MiguelAlvarezBerjon/Electronic-Sound-Tuner/README.md

This project was carried out between September and December 2023 using Multisim, in collaboration with Jaime Santiago, under the guidance of Pablo Zumel from the Electronics Department at Universidad Carlos III de Madrid.
