MiguelAlvarezBerjon/Electronic-Sound-Tuner/Report.pdf

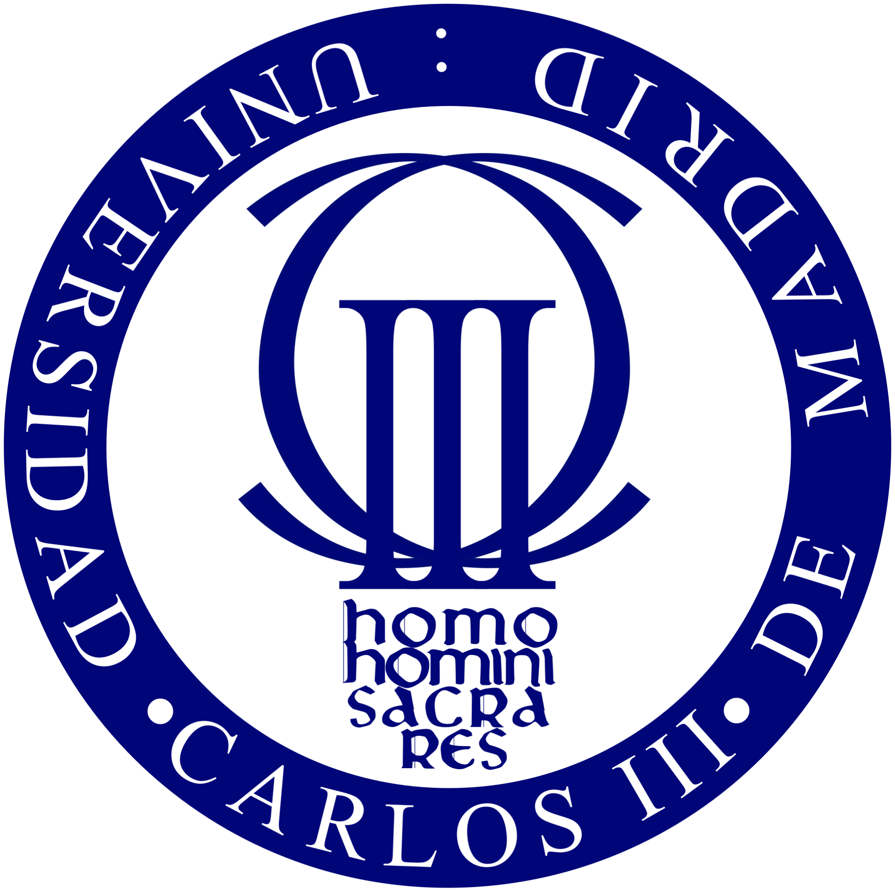
[picture p1: figure]

# INSTRUMENTACIÓN ELECTRÓNICA I

# PROYECTO DE DISEÑO

# Profesor: Pablo Zumel

Miguel Álvarez Berjón
Jaime de Santiago González

PROYECTO DE DISEÑO

ÍNDICE

1. Estado de la técnica
2. Descripción general a nivel de bloques de la solución adoptada
3. Descripción detallada del diseño propuesto que posibilite su reproducción.
4. Caracterización del funcionamiento
5. Presupuesto
6. Valoración crítica
7. Referencias bibliográficas utilizadas

### 1. ESTADO DE LA TÉCNICA

Los afinadores acústicos son ampliamente utilizados mayoritariamente en el campo de la música para saber con exactitud la nota que se está tocando y así poder afinar un instrumento. Desde un punto de vista más técnico, la mayoría de los afinadores indican mediante una señal visual la diferencia del sonido interpretado con el valor de la frecuencia exacta de la nota deseada.
Funcionaría de la siguiente manera: el micrófono captaría un sonido de determinada frecuencia que mediante una serie de circuitos integrados se transformaría en un voltaje determinado.
Este voltaje se compararía con el voltaje de referencia (que corresponde con la nota deseada y posteriormente se mostraría de manera visual o auditivamente para corregir la diferencia de valores.

Puesto que el montaje de dicho circuito se encuentra fuera de nuestras capacidades, el esquemático del proyecto se simplificará de manera significativa.
El micrófono se omitirá de manera que introduciremos la señal de frecuencia sinusoidal al circuito directamente utilizando un generador de funciones.
Dicha señal tendrá un voltaje determinado dado por una curva de calibración que mediante una serie de LEDS indicará qué nota está se recibiendo, según la correspondiente franja de voltaje en donde se encuentre.

Se han seguido las especificaciones dadas, utilizando únicamente los componentes recomendados y sin emplear microcontroladores ni sensores con salida digital.
Esta es una de las posibles soluciones al problema planteado, pero hay un gran número de ellas implementando distintos circuitos integrados cableado

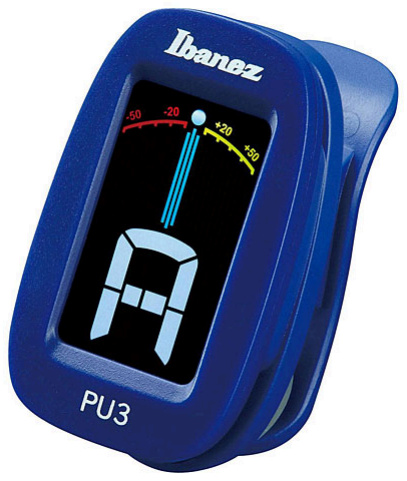
[picture p2: figure]

### 2. Descripción general a nivel de bloques de la solución adoptada

BLOQUE 1: FILTRO PASO BANDA
El TL082 se encuentra en el bloque de acondicionamiento de la señal al principio de circuito y funciona como un filtro paso banda que deja pasar unos niveles de frecuencia con una ganancia determinada por los componentes utilizados en el montaje y así garantizar el correcto funcionamiento del circuito, además de atenuar frecuencias no deseadas;
Consta de dos resistencias y 2 condensadores y recibe la señal del generador de funciones en su pata inversora, mientras que la pata no inversora está conectada a tierra.

BLOQUE 2: COMPARADOR
El LM311 se encuentra a la salida del TL082 para transformar la forma de onda de la frecuencia de senoidal a cuadrada y poder utilizar las puertas lógicas seguidamente; puesto que funciona como comparador y está conectado a conectado a un voltaje de ±5V se garantiza que la amplitud de la nueva onda tendrá 5V de valor máximo y 0 V de valor mínimo.
cuando V+>V-, el valor de la salida V0=+5V, mientras que cuando V-<V+, el valor de V0=0V

BLOQUE 3: CONFORMADOR DE PULSOS
El conformador de pulsos se encarga de general una señal de disparo del 555 continua mediante la implementación de puertas lógicas, además de haber un filtro paso bajo que mediante las funciones lógicas (en este caso únicamente se utilizan puertas NAND) nos da la forma de onda adecuada para el 555.

BLOQUE 4: 555 MONOESTABLE
Produce un pulso de anchura Tw constante que no varía. Recibe una valor de Vtrigger en la pata 2 de pulsos constantes del conformador. En la pata 5 de control de voltaje hemos puesto un condensador de 10nF para eliminar ruido. Puesto que el 555 funciona en modo monoestable, la pata 6 y 7, voltaje umbral y de descarga respectivamente, están conectados entre sí. Se encuentran en paralelo a la resistencia y el condensador del bloque.

BLOQUE 5: FILTRO PASO BAJO
Obtiene una señal continua de los pulsos del 555 adecuada para el circuito de ajuste, está conformado por varias resistencias en serie con un condensador conectado a tierra. Garantiza la atenuación de los valores superiores a la frecuencia de cortes establecida por los valores de los componentes de diseño.

BLOQUE 6: CIRCUITO DE AJUSTE
Sirve como proceso de transformación de la señal a la entrada de los TL082 a una señal pequeña y negativa.

BLOQUE 7: VISUALIZACIÓN
Sirve para, una vez recibe una señal de entrada Vin (entre 0-1,25V), según la frecuencia recibida el LM3914, envía corriente a uno de los leds colocados para, de esta manera, visualizar a simple vista la frecuencia recibida sin ser necesaria ninguna medición con aparatos externos.

### 3. Descripción detallada del diseño propuesto

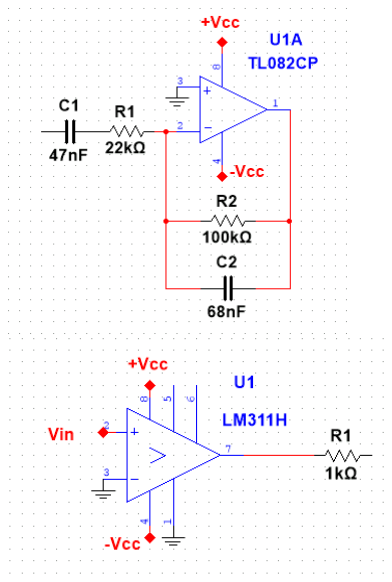
[picture p3: figure]

BLOQUE 1:
- TL082
- Resistencia 22K
- Resistencia 100K
- Condensador 47nF
- Condensador 68nF

BLOQUE 2:
- LM311P
- Resistencia 1K

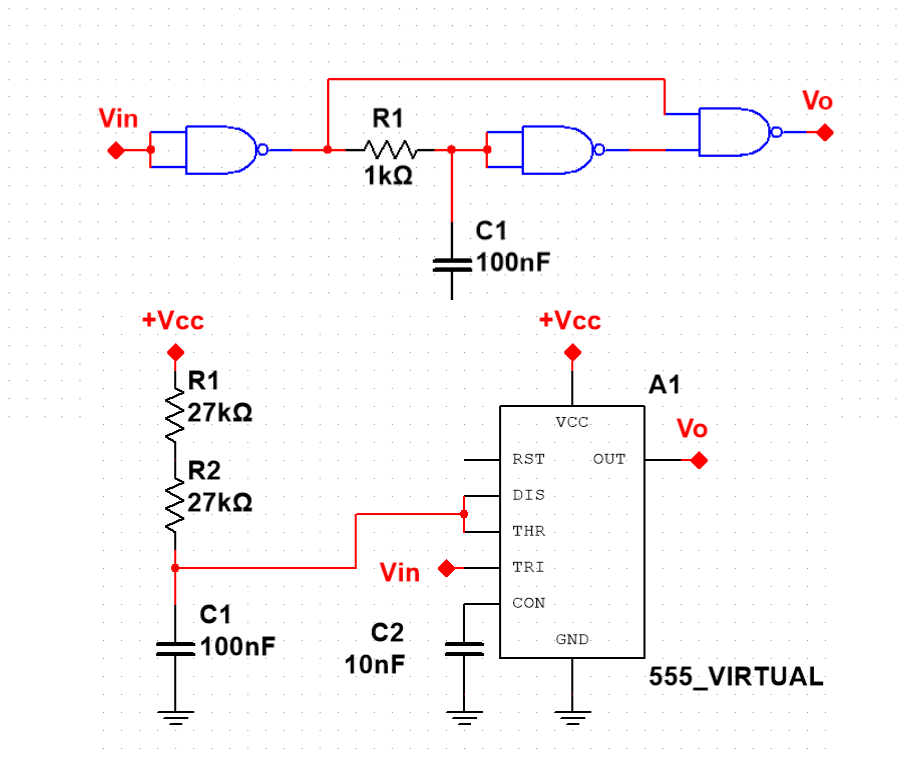
[picture p4: figure]

BLOQUE 3:
- SN74HC132N
- Resistencia 1K
- Condensador 10nF
BLOQUE 4:
- NE555P
- Resistencias
- Resistencias
- Resistencias
- Condensador
- Condensador

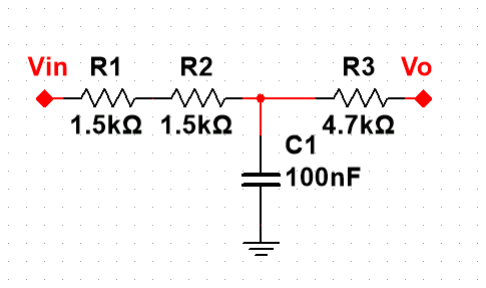
[picture p5: figure]

BLOQUE 5:
- Resistencia 4.7K
- Resistencia 1.5K
- Condensador 100nF

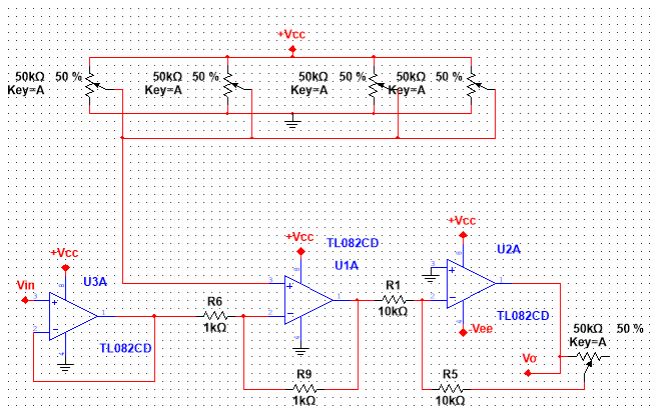
[picture p6: figure]

BLOQUE 6:
- TL082
- Resistencia 1K
- Resistencia 10K
- Resistencia 1K
- Potenciómetro 50K

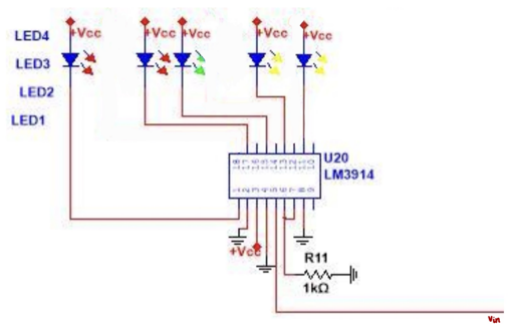
[picture p7: figure]

BLOQUE 7:
- Leds
- LM3914N-1
- Resistencia 1K

### 4. Caracterización del funcionamiento

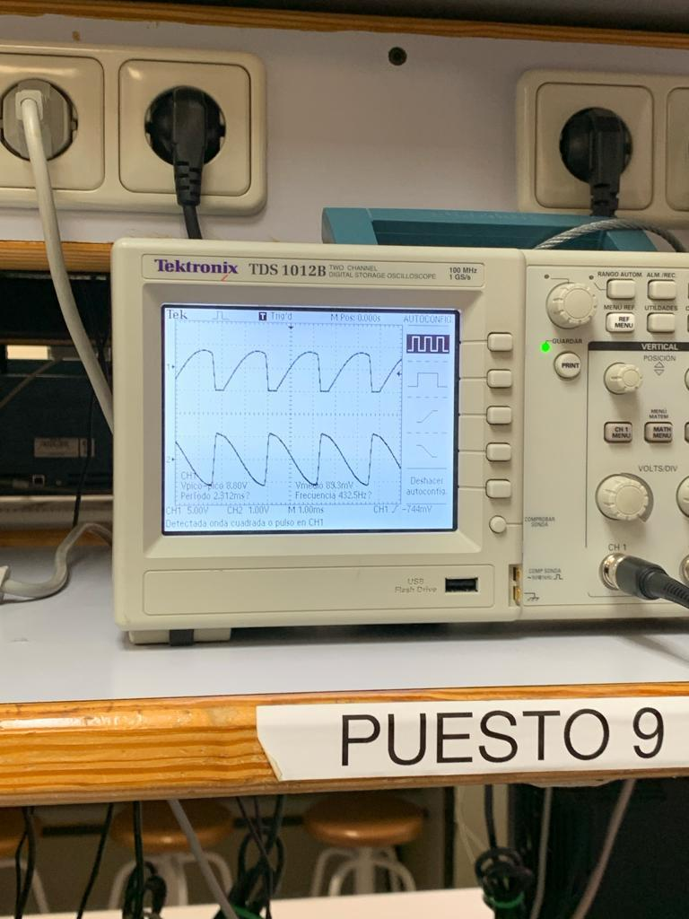
[picture p8: figure]

BLOQUE 1: FILTRO PASO BANDA

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
1+ sC
2

R
2

Z

1 = R

1 +

1
sC
1

=

1+ sC
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
(1+sR
1

C
1

)(1+sR
2

C
2

)

Polos:

1 + sR
1

C

1 = 0 → s = −

1
R
1

C
1
f

p1 =

1
2ΠR
1

C
1

1 + sR
2

C

2 = 0 → s = −

1
R
2

C
2
f

p2 =

1
2ΠR
2

C
2

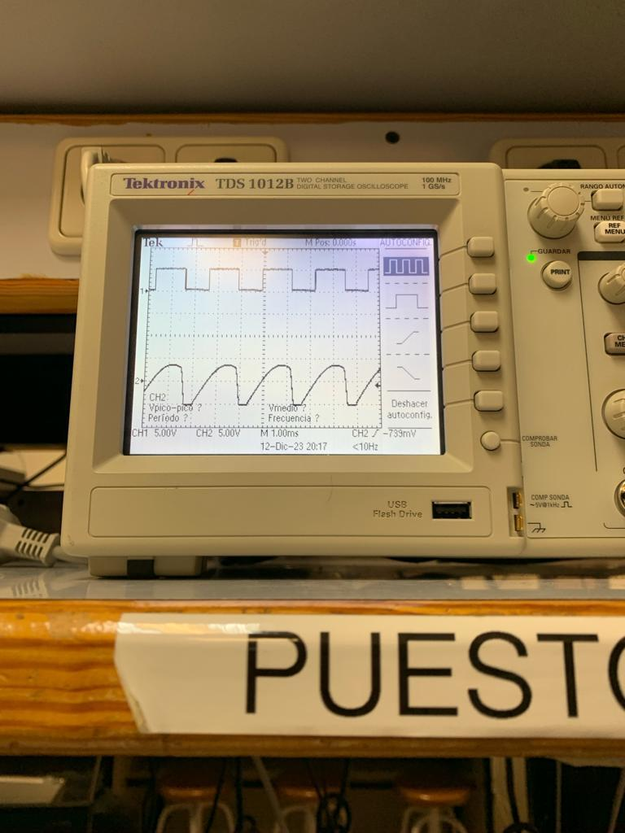
[picture p9: figure]

Frecuencia Media:

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
BLOQUE 2: COMPARADOR

- V+>V- entonces V0=+5V
- V-<V+ entonces V0=0V

BLOQUE 3: COMPARADOR DE PULSOS

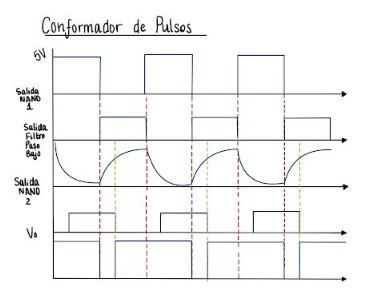
[picture p10: figure]

BLOQUE 4: 555 MODO MONOESTABLE

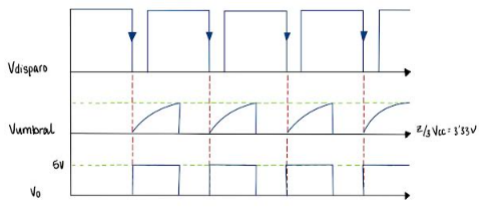
[picture p11: figure]

El valor de Tw lo obtenemos aplicando teoría;

Vc1 (t = tw) = VA = Vcc × (1 − e | que resolviendo nos da el valor:

−tw
R1×C1
)
T

W = 1, 1 * R
A

* C

A ≤ T

min =

1

fmaz

BLOQUE 5: FILTRO PASO BAJO

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
1+SRC

→ 1

er Orden

1 + SRC = 0 → S = −

1
RC
f

p =

1
2ΠRC ≤

f

in min
100

En ambos filtros:

V

O = V

inmed =

1
T
0

T
∫ V
in

dt =

1
T
- V
cc
- T
w
V

O = V
cc
- T
w
- f

BLOQUE 6: CIRCUITO DE AJUSTE

V

07 = V
07

Vof = 0 + V
07

Vx = 0 =−

R
7
R
6

V

x + (1 +

R
7
R
6

)V

of = − V

06 + 2V
of

V

07 = − V

06 + 2αs → En este punto, en el proceso de calibración debe ℎaber tensión

pequeña y negativa

V

08 = −

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
08 = −

αR

p+R
9
R
8
- [− V

06 + 10α ] =

αR

P+R
9
R
8
- [ T
W
- V
CC
- f − 10α]

BLOQUE 7: VISUALIZACIÓN

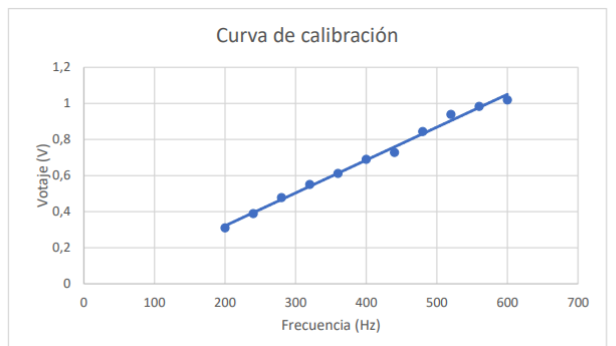
[picture p12: figure]

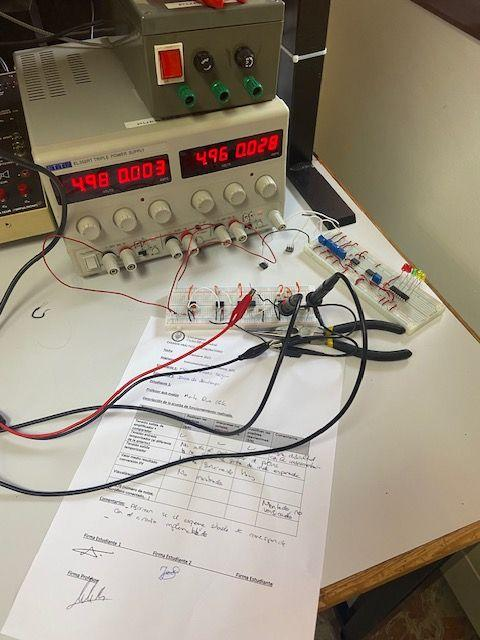
[picture p13: figure]

### 5. Presupuesto

PIEZAS | COSTE (€)
Protoboard x3 | 18
Cableado 1m x3 | 3
Resistencia 22K | 1
Resistencia 100K | 1
Resistencia 1.5K | 1
Resistencia 4.7K | 1
Resistencia 27K | 1
Resistencia 10K | 1
Potenciómetro 50K x5 | 3
Condensador 10nF x2 | 0.4
Condensador 100nF x2 | 0.4
Condensador 68nF | 0.2
Condensador 47nF | 0.2
TL082 x3 | 3.6
LM311P | 5.5
SN74CH132N | 0.8
NE555P | 0.6
LM3914N-1 | 1
TOTAL | 42.7

Como ya se explicará en el siguiente apartado, el presupuesto obtenido es más orientativo que fiel a la realidad debido a las numerosas compras de componentes que hicimos.

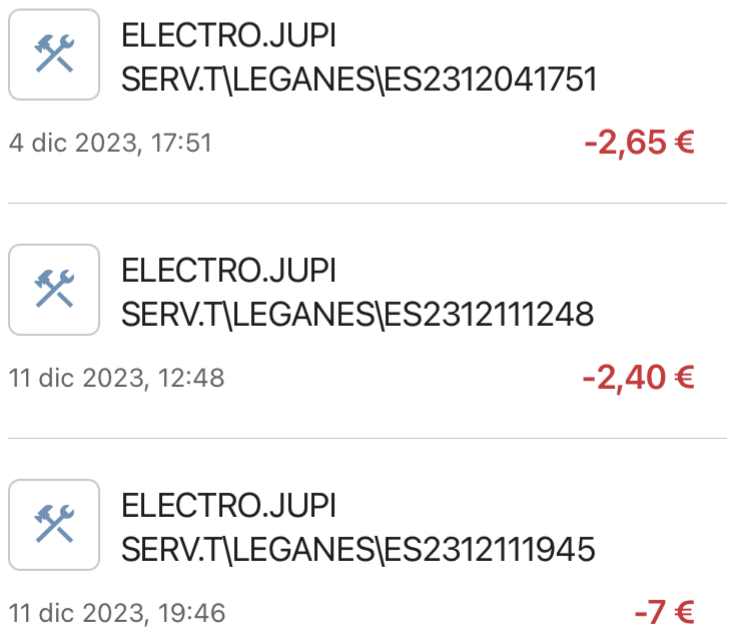
[picture p14: figure]
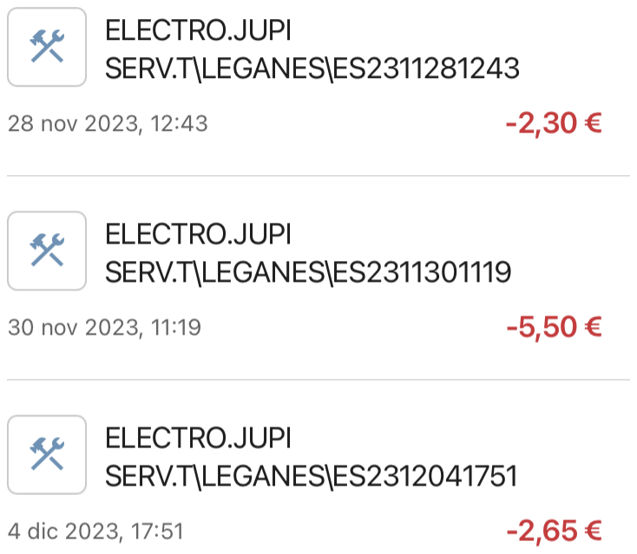
[picture p15: figure]
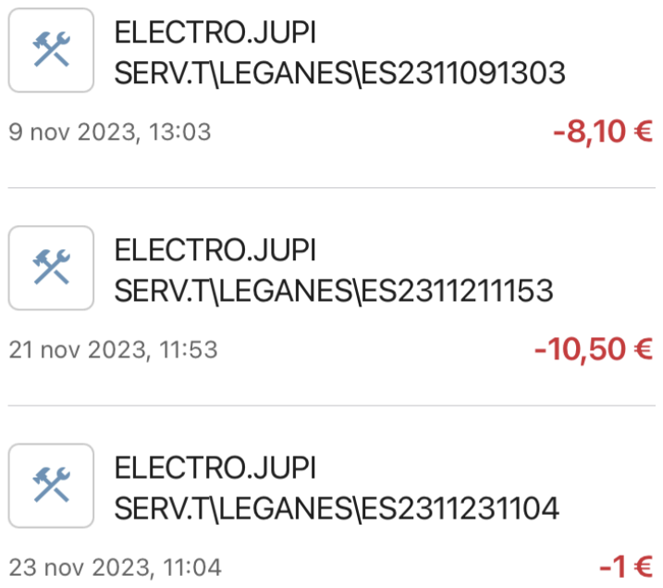
[picture p16: figure]

### 6. Valoración crítica

El montaje nos ha resultado complicado en general, ya sea por falta de experiencia en el montaje de circuito y los constantes cambios de diseño en la primera parte (hasta el 555). Estas son algunas de las primeras pruebas junto con el diseño final que hicimos. Lo repetimos numerosas veces debido a las formas de onda inconclusas que nos daban.

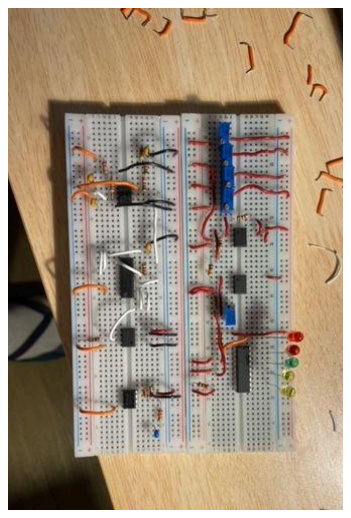
[picture p17: figure]
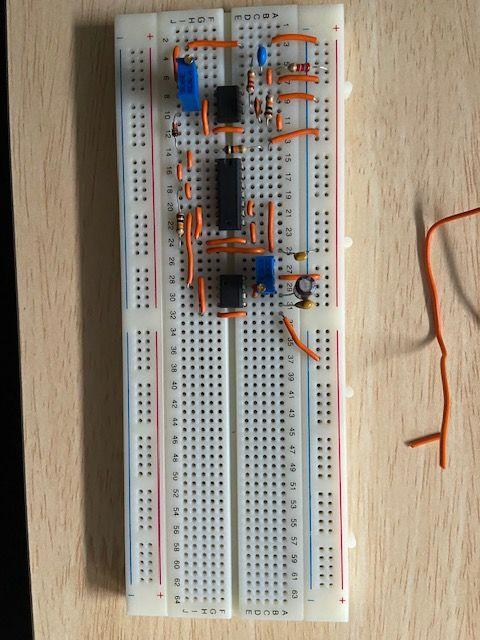
[picture p18: figure]
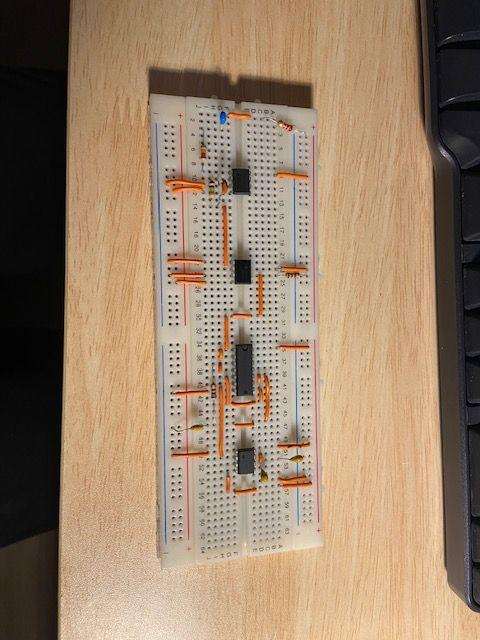
[picture p19: figure]

Compramos varias veces los mismos componentes por miedo de haberlos quemado durante las prácticas y no fue hasta los 2 días previos al exámen donde se nos ocurrió cambiar la protoboard por una nueva, que resultó ser la causa de los reiterados fallos en las mediciones . Esto fue la dificultad principal del proyecto puesto que no sabíamos si estábamos montando el circuito de manera adecuada, lo que nos llevó a dudar en el exámen debido a la sorpresa de que nos funcionara algo.

Otras complicaciones de diseño fue la elección del montaje de los LED, ya que el esquemático de aula global nos resultaba dificultoso, por lo que decidimos conectar los LEDS al LM3914 siguiendo las recomendaciones de varios compañeros de clase que habían tenido el mismo problema. De nuevo, al no poder haber probado esta parte del circuito por los problemas mencionados de la primera parte del circuito, no hemos podido comprobar su funcionamiento. Aun así, hemos revisando el montaje y todos los componentes están acorde al montaje, por lo que suponemos que a no ser de la falla de algún circuito integrado o cable, debería de habernos funcionado correctamente

La elección de los valores de las resistencias en el paso banda del circuito de acondicionamiento y el filtro paso bajo también resultaron complicadas debido a los numerosos cálculos que acarreaban.

Algunos de los puntos débiles/fallos observados durante el exámen de proyecto son los siguientes:

- El 555 no funciona de la manera correcta puesto que no recibiamos una frecuencia continua sino con forma cuadrada, lo que indica que el filtro paso bajo no estaba bien conectado

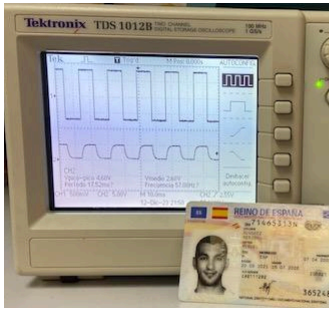
[picture p20: figure]

- El conformador de pulsos nos daba una señal inversa, desconocemos la razón de porqué puesto que al poner otro SN74HC132N, la forma de onda daba de manera correcta sin cambiar ningún ni los componentes ni el cableado.
- Esta forma de onda es la más parecida a la deseada que obtuvimos del 555 durante el exámen, ya que es casi continua, pero la entrada está invertida debido al anterior fallo comentado del conformador de señales. Posteriormente solucionamos el problema de la inversión, pero debimos de cambiar la posición de algún componente para que ya no nos diera continua (ver imagen anterior).

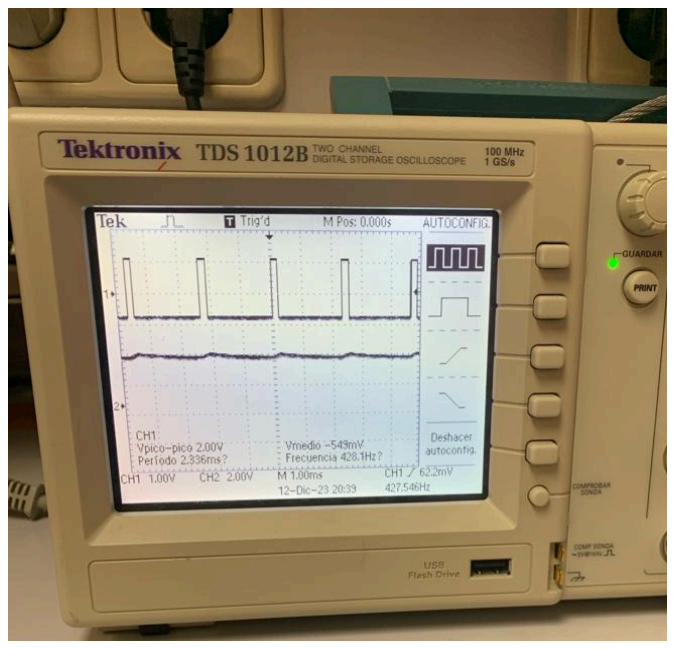
[picture p21: figure]

7. Referencias bibliográficas utilizadas (se incluirán los DATASHEET de los componentes utilizados)

Webgrafía:

https://es.wikipedia.org/wiki/Afinador_electr%C3%B3nicohttps://hetpro-store.com/TUTORIALES/compuertas-logicas/https://unicrom.com/lm311-comparador-de-voltaje/https:/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

Listado datasheets utilizados:

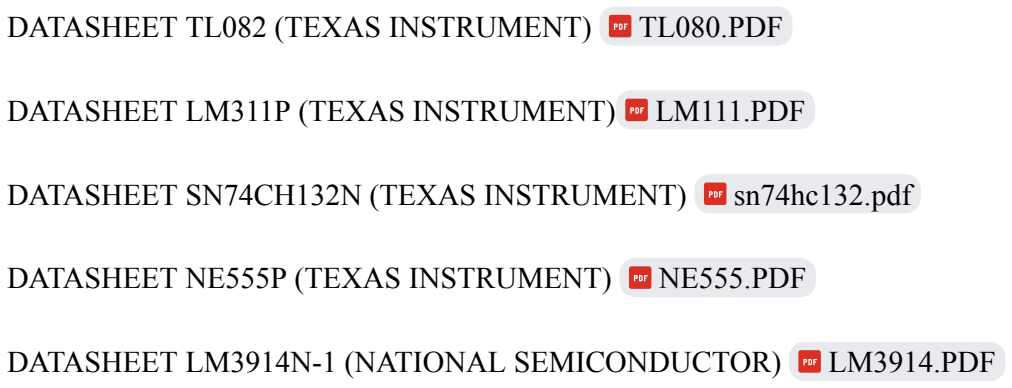
[picture p22: figure]
DATASHEET TL082 (TEXAS INSTRUMENT); TL080.PDF; DATASHEET LM311P (TEXAS INSTRUMENT) LM111.PDF; DATASHEET SN74CH132N (TEXAS INSTRUMENT); sn74hc132.pdf; DATASHEET NE555P (TEXAS INSTRUMENT); NE555.PDF; DATASHEET LM3914N-1 (NATIONAL SEMICONDUCTOR); LM3914.PDF
