MiguelAlvarezBerjon/Electronic-Sound-Tuner/(list of files, drawings)

Other design files:
Schematics.ms14
